shen747/LocalAiRobot/brain/faces/alarmed/01.png

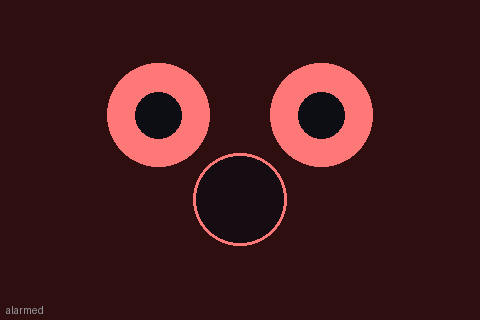
brain/faces/alarmed/01.png
