shen747/LocalAiRobot/brain/faces/exploring/01.png

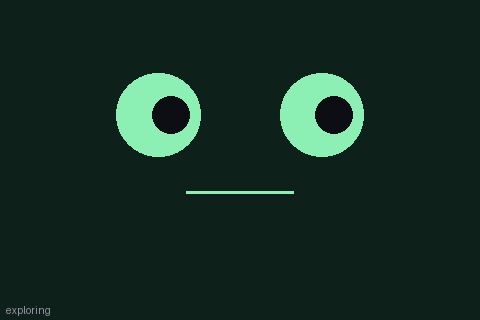
brain/faces/exploring/01.png
