shen747/LocalAiRobot/brain/faces/halloween/04.png

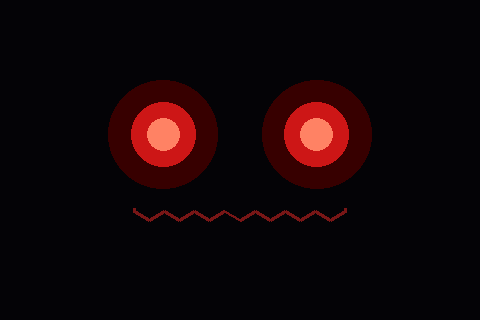
brain/faces/halloween/04.png
