shen747/LocalAiRobot/brain/faces/halloween/05.png

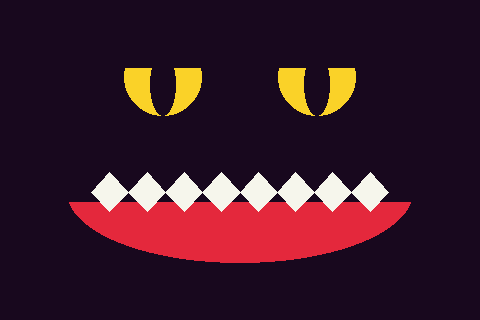
brain/faces/halloween/05.png
