shen747/LocalAiRobot/brain/faces/halloween/06.png

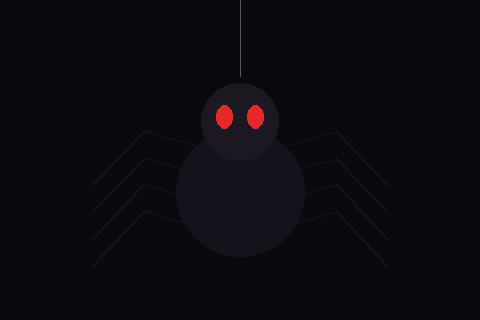
brain/faces/halloween/06.png
