shen747/LocalAiRobot/brain/faces/halloween/08.png

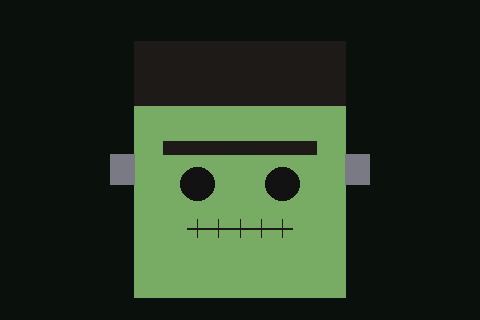
brain/faces/halloween/08.png
