shen747/LocalAiRobot/brain/faces/halloween/09.png

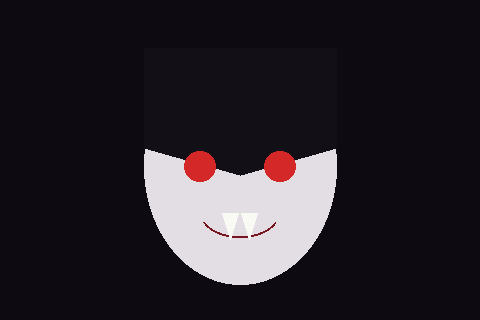
brain/faces/halloween/09.png
