shen747/LocalAiRobot/brain/faces/idle/01.png

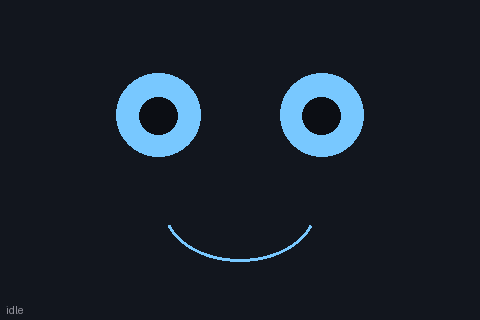
brain/faces/idle/01.png
