shen747/LocalAiRobot/brain/faces/inquisitive/01.png

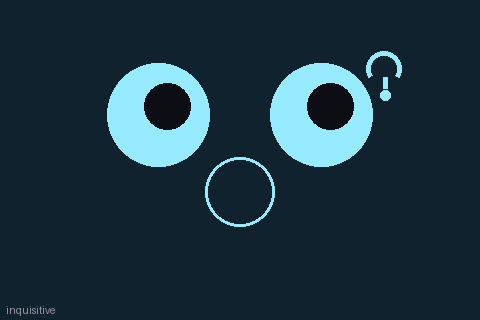
brain/faces/inquisitive/01.png
