shen747/LocalAiRobot/brain/faces/thinking/01.png

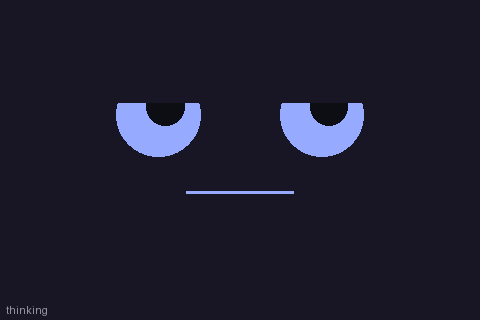
brain/faces/thinking/01.png
