shen747/LocalAiRobot/docs/enclosure_models/junction_box_base.jpg

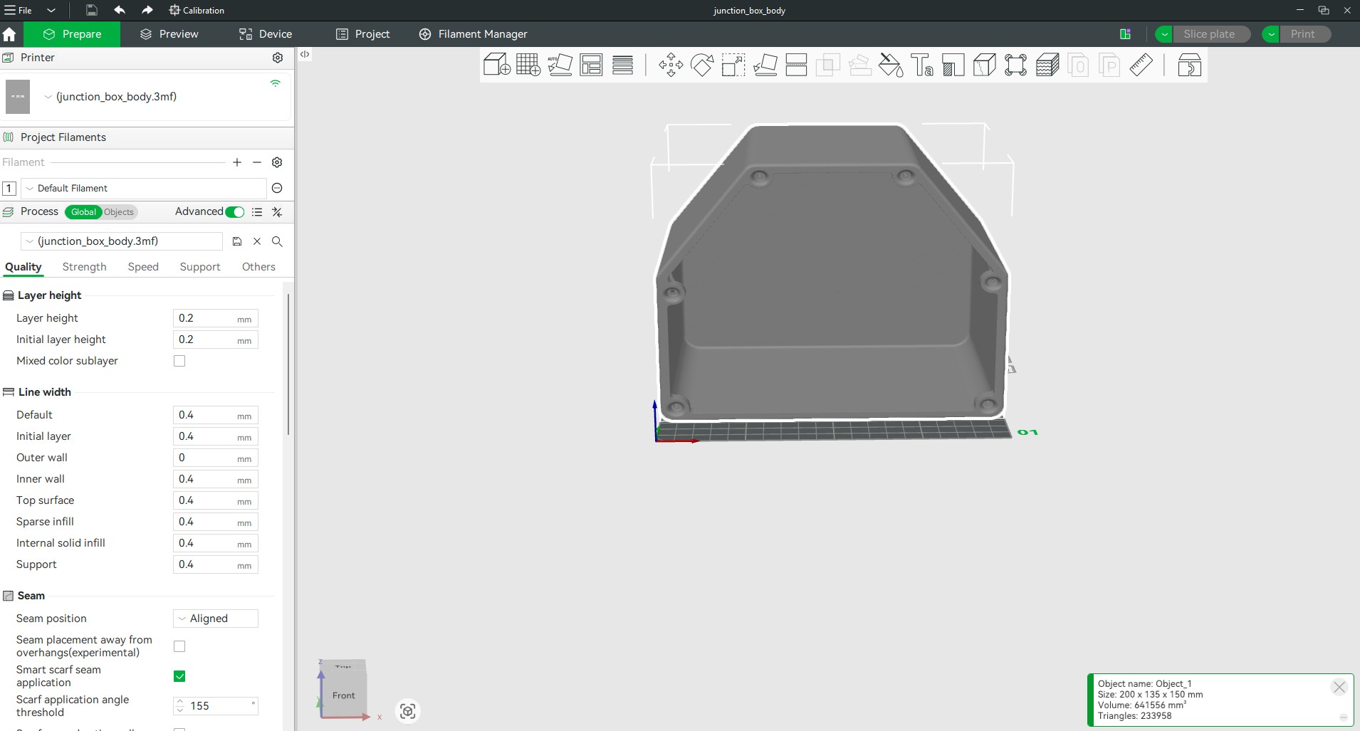
docs/enclosure_models/junction_box_base.jpg
