shen747/LocalAiRobot/docs/enclosure_models/junction_box_base_material.jpg

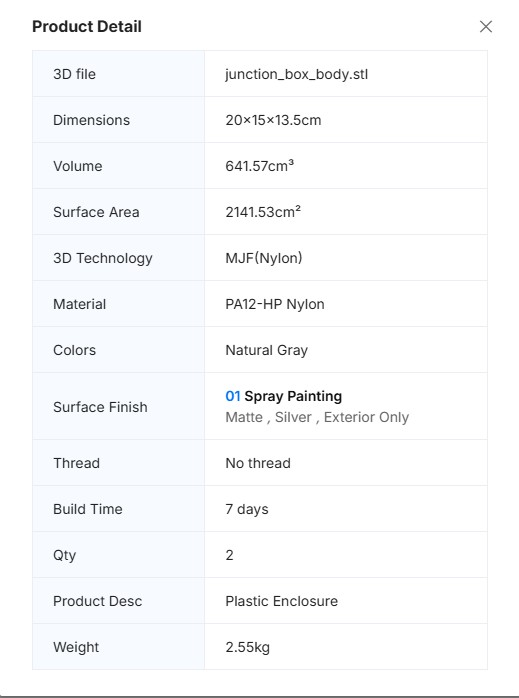
docs/enclosure_models/junction_box_base_material.jpg
