shen747/LocalAiRobot/docs/enclosure_models/junction_box_lid_material.jpg

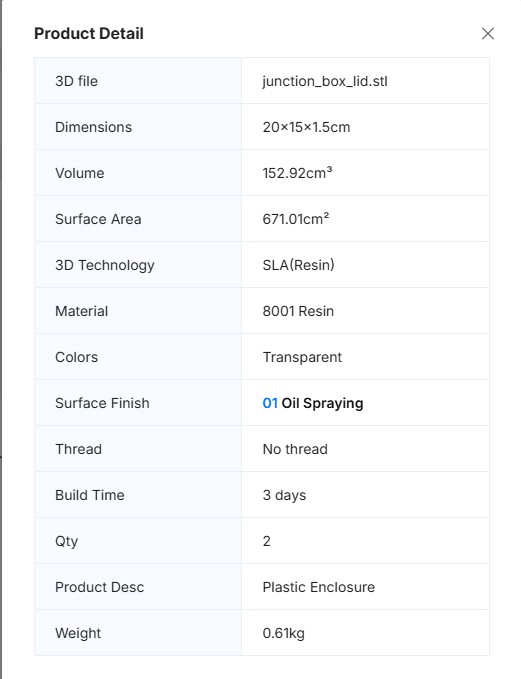
docs/enclosure_models/junction_box_lid_material.jpg
