shen747/LocalAiRobot/docs/enclosure_models/junction_box_lid.3mf

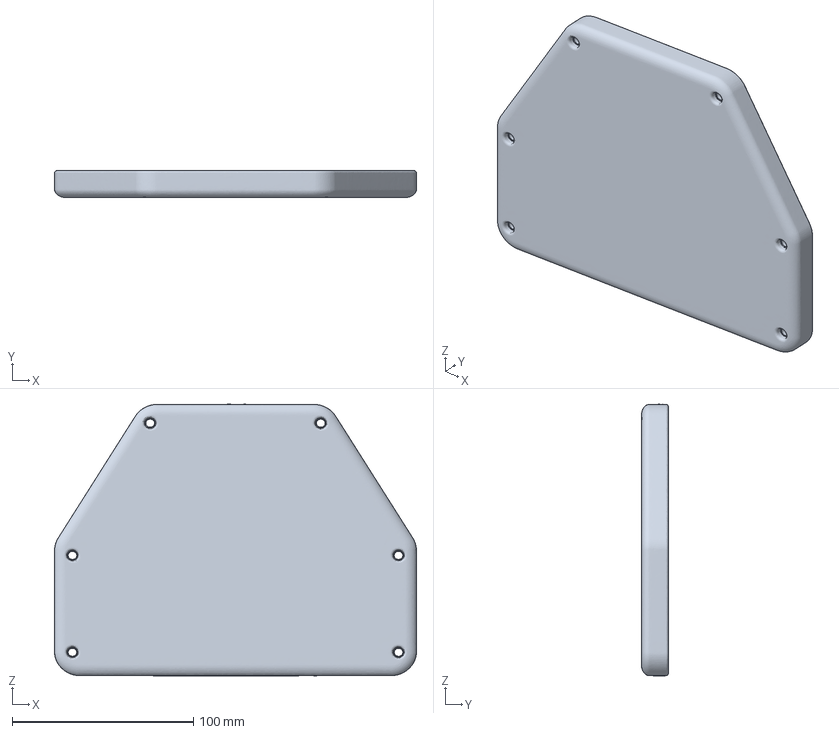
[picture p18: CAD file, 2026-11-03]
docs/enclosure_models/junction_box_lid.3mf
200.0 x 15.0 x 150.0 mm
