shen747/LocalAiRobot/docs/enclosure_models/junction_box_body.3mf

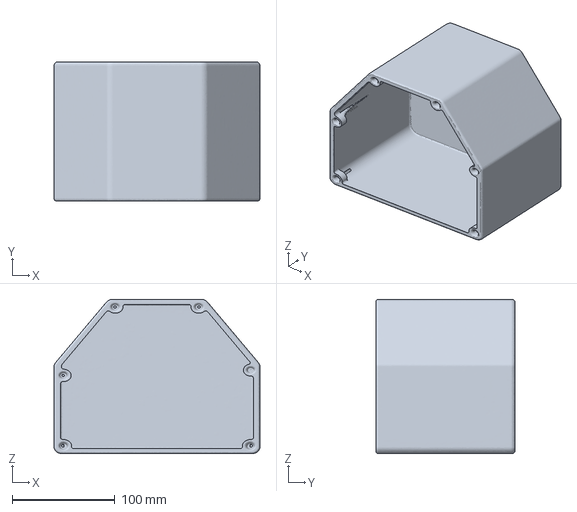
[picture p19: CAD file, 2026-11-03]
docs/enclosure_models/junction_box_body.3mf
200.0 x 135.0 x 150.0 mm
