shen747/LocalAiRobot/docs/images/wiring.png

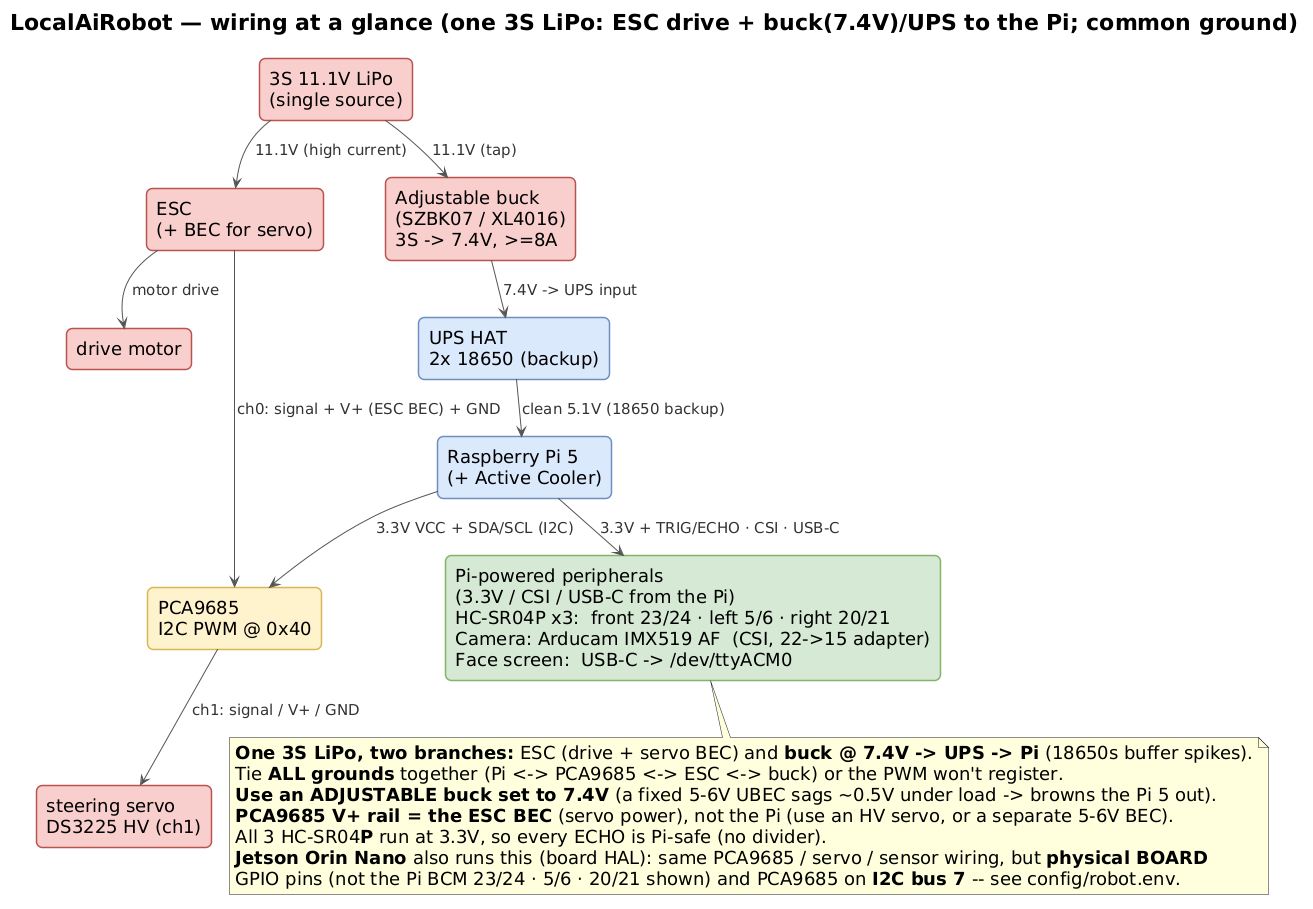
docs/images/wiring.png
