shen747/LocalAiRobot/brain/face.py

# brain/face.py -- the robot's face: an expression state machine on a small display.
#
# main.py / behavior.py call set_expression("listening"|"thinking"|"talking"|"exploring"|
# "happy"|"confused"|"alarmed"|"warmup"|"capturing"|"idle") on events. Each state renders either
# a multi-frame PNG ANIMATION (if assets exist for it) or, as a zero-asset fallback, a procedural
# cartoon face drawn with Pillow. Frames are pushed to a backend:
#
#   turing       -> the 3.5" USB-C panel via mathoudebine/turing-smart-screen-python (serial).
#   framebuffer  -> a DSI/HDMI panel, PIL frame written straight to /dev/fb0 as RGB565
#                   (NOT pygame/SDL -- KMSDRM is broken on headless Pi 5).
#   simulated    -> no display: logs "FACE -> <state>" on change (and optionally dumps a PNG).
#   auto         -> try turing, then framebuffer, else simulated.
#
# ANIMATION: drop PNG sequences in <ROBOT_FACE_FRAMES_DIR>/<state>/NN.png (default brain/faces).
# A state with >=2 frames animates on a background daemon thread (talking is fast + random-frame
# to fake a moving mouth, like the reference); 1 frame = a static still; 0 frames = the procedural
# drawing. Even with NO PNGs, the procedural TALKING face animates its mouth open/closed so speech
# looks alive (see _PROC_ANIMATED); every other state stays a static procedural drawing.
#
# EVERYTHING here is best-effort and never raises into the caller: a missing panel, missing Pillow,
# or an unreadable asset degrades to simulated / procedural and the robot runs on. The face is
# cosmetic; it must never block driving.

import logging
import os
import random
import re
import threading

from driver import dry_run_enabled

log = logging.getLogger("robot.face")

STATES = ("idle", "listening", "thinking", "talking", "exploring",
          "happy", "confused", "alarmed", "warmup", "capturing",
          "inquisitive", "sleeping")

# Per-mood drawing params: bg tint, eye colour, pupil look (dx,dy in -1..1), mouth style,
# and flags for happy (^^) eyes / wide (startled) eyes / drooped lids.
_MOODS = {
    "idle":      dict(bg=(18, 22, 30),  eye=(120, 200, 255), look=(0.0, 0.05),  mouth="smile_s"),
    "listening": dict(bg=(14, 30, 42),  eye=(120, 220, 255), look=(0.0, 0.0),   mouth="o", wide=True),
    "thinking":  dict(bg=(24, 22, 36),  eye=(150, 170, 255), look=(0.35, -0.4), mouth="flat", lid=0.35),
    "talking":   dict(bg=(14, 28, 40),  eye=(120, 210, 255), look=(0.0, 0.0),   mouth="open"),
    "exploring": dict(bg=(14, 32, 26),  eye=(140, 240, 180), look=(0.6, 0.0),   mouth="flat"),
    "happy":     dict(bg=(20, 34, 22),  eye=(150, 255, 160), look=(0.0, 0.0),   mouth="smile_b", happy=True),
    "confused":  dict(bg=(36, 28, 14),  eye=(255, 210, 120), look=(-0.25, -0.1),mouth="wavy", lid=0.3),
    "alarmed":   dict(bg=(46, 14, 14),  eye=(255, 120, 120), look=(0.0, 0.0),   mouth="open", wide=True),
    # added states: warmup (model loading at boot) + capturing (camera grab before a vision look)
    "warmup":    dict(bg=(20, 20, 34),  eye=(160, 180, 255), look=(0.0, 0.0),   mouth="flat", lid=0.2),
    "capturing": dict(bg=(12, 30, 38),  eye=(150, 230, 255), look=(0.0, -0.1),  mouth="o", wide=True),
    # inquisitive: shown the instant "hey jarvis" wakes it -- wide bright eyes glancing up-and-aside, curious
    # "o" mouth (distinct from listening's straight-ahead look). sleeping: shown when a conversation ends on
    # silence -- peaceful CLOSED eyes (sleep=True), a soft smile, and floating "Zzz".
    "inquisitive": dict(bg=(16, 34, 46), eye=(150, 235, 255), look=(0.35, -0.35), mouth="o", wide=True, query=True),
    "sleeping":    dict(bg=(14, 14, 26), eye=(120, 160, 220), look=(0.0, 0.0),    mouth="smile_s", sleep=True),
    # halloween: the spook face shown on a Halloween-mode motion wake. 10 committed PNG frames in
    # brain/faces/halloween/ are shown ONE-AT-RANDOM per visitor (see _RANDOM_STILL); this procedural entry is
    # only the FALLBACK if those PNGs are missing -- a jack-o'-lantern glow (dark bg, orange eyes, jagged mouth).
    "halloween":   dict(bg=(16, 6, 2),   eye=(255, 140, 20),  look=(0.0, 0.0),    mouth="wavy", wide=True),
    # weather: the 3-day forecast CARD that stands in for the sleeping face when weather is enabled and a
    # forecast is in hand (brain/weather_screen.py builds the frames; Face.set_frames registers them). Like
    # halloween this is registered in _MOODS but NOT in STATES -- STATES drives scripts/generate_faces.sh,
    # and a procedurally-drawn cartoon "weather face" is not a thing anyone wants on disk. This entry is
    # purely the whitelist ticket set_expression() demands (an unlisted state is silently coerced to idle)
    # plus a fallback drawing; it is deliberately the sleeping face's palette, because the only way to see
    # it is a card that failed to build, and "asleep" is then the honest thing to show.
    "weather":     dict(bg=(14, 14, 26), eye=(120, 160, 220), look=(0.0, 0.0),    mouth="smile_s", sleep=True),
}

# Per-state animation timing, used ONLY when a state has >=2 PNG frames: (fps, loop).
# talking is the one state where higher fps earns its keep (it tracks speech); the others are a
# cheap slow loop. loop=False holds the last frame (good for brief transient states).
_TIMING = {
    "talking":   (15.0, True),
    "thinking":  (3.0, True),
    "listening": (3.0, True),
    "exploring": (3.0, True),
    "warmup":    (2.0, True),
    "capturing": (2.0, False),
    "happy":     (4.0, False),
    "confused":  (3.0, False),
    "alarmed":   (4.0, True),
    # weather: loop=True is the load-bearing half. An UNLISTED state defaults to loop=False below, which
    # holds the last frame -- the forecast card would animate once and then freeze for the rest of the
    # drowse. The fps here is cosmetic: _timing() substitutes the global ROBOT_FACE_FPS for every state
    # except talking, and the Turing panel clamps that to 10.
    "weather":   (4.0, True),
}
_DEFAULT_TIMING = (2.0, False)

# States that ANIMATE PROCEDURALLY even with no PNG frames -- re-rendered with an advancing frame counter
# so the drawing itself moves (currently just the talking mouth). A >=2-frame PNG set overrides this.
_PROC_ANIMATED = frozenset({"talking"})
# States that show ONE RANDOM frame per entry and HOLD it (vs animating through the whole set). Halloween's
# spook face: a different monster for each trick-or-treater, frozen for that encounter.
_RANDOM_STILL = frozenset({"halloween"})
# talking mouth openness cycle (0 = nearly closed, 1 = wide) -> a mouth-like flap when re-rendered per frame.
_TALK_OPEN = (0.15, 0.55, 1.0, 0.6, 0.25, 0.85, 0.45)
# P2-11: the tiny bench state label is OFF by default (it shipped to the user-facing concierge face). Read
# once at module scope -- the talking face re-renders at up to 10-15 fps. Set ROBOT_FACE_DEBUG_LABEL=1 to show.
_DEBUG_LABEL = os.environ.get("ROBOT_FACE_DEBUG_LABEL", "0").strip().lower() in ("1", "true", "yes", "on")


def _frame_key(name):
    """Sort frames by the integer in the filename: tolerates 'thinking 04.png' and '04.png'."""
    m = re.search(r"(\d+)", name)
    return (int(m.group(1)) if m else 0, name)


def _render(state, w, h, frame=0):
    """Procedural cartoon face -> PIL.Image, or None if Pillow is unavailable. `frame` advances the
    animated bits (the talking mouth); it's ignored for the static moods."""
    try:
        from PIL import Image, ImageDraw
    except Exception:
        return None
    m = _MOODS.get(state, _MOODS["idle"])
    img = Image.new("RGB", (w, h), m["bg"])
    d = ImageDraw.Draw(img)
    eye = m["eye"]
    wide = m.get("wide", False)
    er = h * (0.16 if wide else 0.13)        # eye radius
    cy = h * 0.36                            # eye centre y
    lx, rx = w * 0.33, w * 0.67              # eye centre x (left/right)
    dx, dy = m["look"]

    def draw_eye(cx):
        if m.get("sleep"):                   # closed, peaceful eye = a gentle downward-cup arc (a content ‿)
            d.arc([cx - er, cy - er * 0.6, cx + er, cy + er * 0.7], start=20, end=160,
                  fill=eye, width=max(3, int(er * 0.32)))
            return
        if m.get("happy"):                   # ^^ happy eyes = upward arcs
            d.arc([cx - er, cy - er, cx + er, cy + er], start=200, end=340, fill=eye, width=max(3, int(er * 0.35)))
            return
        d.ellipse([cx - er, cy - er, cx + er, cy + er], fill=eye)          # eyeball
        pr = er * 0.45                                                      # pupil
        px, py = cx + dx * er * 0.5, cy + dy * er * 0.5
        d.ellipse([px - pr, py - pr, px + pr, py + pr], fill=(12, 14, 20))
        lid = m.get("lid", 0.0)                                            # drooped/raised lid
        if lid:
            d.rectangle([cx - er, cy - er, cx + er, cy - er + 2 * er * lid], fill=m["bg"])

    draw_eye(lx)
    draw_eye(rx)

    # mouth. Size it off the SHORT axis (min(w,h)) so a wide landscape canvas doesn't blow the smile up
    # until it runs off the bottom, and sit it a little higher (0.60h) so the big 'happy' smile clears the edge.
    mx, my = w * 0.5, h * 0.60
    mw = min(w, h) * 0.24
    style = m["mouth"]
    line = max(3, int(h * 0.012))
    if style == "smile_s":
        d.arc([mx - mw, my - mw * 0.5, mx + mw, my + mw * 0.9], 20, 160, fill=eye, width=line)
    elif style == "smile_b":
        d.arc([mx - mw, my - mw * 0.7, mx + mw, my + mw * 1.1], 10, 170, fill=eye, width=line + 2)
    elif style == "flat":
        d.line([mx - mw * 0.7, my, mx + mw * 0.7, my], fill=eye, width=line)
    elif style == "o":
        r = mw * 0.45
        d.ellipse([mx - r, my - r, mx + r, my + r], outline=eye, width=line)
    elif style == "open":
        # talking VARIES the openness by frame (fakes a moving mouth); other 'open' moods stay wide.
        amt = _TALK_OPEN[frame % len(_TALK_OPEN)] if state == "talking" else 1.0
        d.ellipse([mx - mw * 0.6, my - mw * 0.5 * amt, mx + mw * 0.6, my + mw * 0.7 * amt],
                  fill=(20, 12, 16), outline=eye, width=line)
    elif style == "wavy":
        pts, n = [], 6
        for i in range(n + 1):
            xx = mx - mw + (2 * mw) * i / n
            yy = my + (mw * 0.18 if i % 2 else -mw * 0.18)
            pts.append((xx, yy))
        d.line(pts, fill=eye, width=line)

    # Sleepy "Zzz" (three ascending Z's, drawn as strokes so no font is needed) + a curious "?" accent.
    if m.get("sleep"):
        for i, s in enumerate((h * 0.05, h * 0.07, h * 0.10)):
            zx, zy = w * (0.66 + i * 0.07), h * (0.30 - i * 0.09)
            _draw_z(d, zx, zy, s, eye, max(2, int(h * 0.012)))
    if m.get("query"):
        _draw_query(d, w * 0.80, h * 0.16, h * 0.11, eye, max(3, int(h * 0.016)))

    if _DEBUG_LABEL:
        d.text((6, h - 16), state, fill=(150, 150, 160))   # bench debug label (ROBOT_FACE_DEBUG_LABEL=1)
    return img


def _draw_z(d, x, y, s, color, wdt):
    """A 'Z' glyph from three strokes (top bar, diagonal, bottom bar) -- no font dependency."""
    d.line([(x, y), (x + s, y)], fill=color, width=wdt)
    d.line([(x + s, y), (x, y + s)], fill=color, width=wdt)
    d.line([(x, y + s), (x + s, y + s)], fill=color, width=wdt)


def _draw_query(d, x, y, s, color, wdt):
    """A '?' glyph: a hooked arc + a dot below -- drawn as strokes so no font is needed."""
    r = s * 0.5
    d.arc([x - r, y, x + r, y + s], start=150, end=390, fill=color, width=wdt)  # the top hook
    d.line([(x + r * 0.1, y + s * 0.75), (x + r * 0.1, y + s * 1.05)], fill=color, width=wdt)  # stem
    dot = max(wdt, int(s * 0.10))
    d.ellipse([x + r * 0.1 - dot, y + s * 1.25 - dot, x + r * 0.1 + dot, y + s * 1.25 + dot], fill=color)  # dot


class _SimulatedBackend:
    def __init__(self, w, h):
        self.width, self.height = w, h
        self._dump = os.environ.get("ROBOT_FACE_DUMP", "").strip()  # optional dir to save PNGs
        self._last = None
        log.info("face backend: simulated (no panel; logs expressions on change%s)",
                 f", dumps PNGs to {self._dump}" if self._dump else "")

    def show(self, state, img):
        # Log + dump only on a STATE CHANGE so animation frames don't flood the console / disk.
        if state == self._last:
            return
        self._last = state
        log.info("FACE -> %s", state)
        if self._dump and img is not None:
            try:
                os.makedirs(self._dump, exist_ok=True)
                img.save(os.path.join(self._dump, f"face_{state}.png"))
            except Exception:
                pass

    def close(self):
        pass


class _TuringBackend:
    """USB-C panel via mathoudebine/turing-smart-screen-python (serial protocol).

    Orientation: the panel is portrait-native (e.g. 320x480). ROBOT_FACE_ORIENTATION rotates the rendered
    face into the panel's frame so a panel MOUNTED SIDEWAYS reads upright. 'landscape'/'reverse_landscape'
    draw the face on a WIDE logical canvas (e.g. 480x320) -- so the whole face system (procedural renderer
    + PNG assets) lays out horizontally -- and show() rotates it 90deg into the native portrait frame right
    before the serial push. 'portrait' is the native frame; 'reverse_landscape'/'reverse_portrait' flip
    which edge is 'up' (use them if the face comes out upside-down for your mounting).

    Speed: a full frame is a slow serial paint on rev A (you watch it 'slide' in). When only PART of the
    face changed between frames (e.g. the talking mouth), we send just that bounding box via a positioned
    DisplayPILImage -- far less serial traffic -- and skip the push entirely when nothing changed. A big
    change (a mood switch repaints most of the screen) still sends a full frame. ROBOT_FACE_PARTIAL=0
    forces full frames (set it if a panel mis-renders positioned sub-images)."""

    def __init__(self, w, h, port, revision, brightness, libdir, orientation="landscape", partial=True):
        import sys
        sys.path.insert(0, os.path.expanduser(libdir))
        rev = (revision or "A").upper()
        if rev == "B":
            from library.lcd.lcd_comm_rev_b import LcdCommRevB as Lcd
        else:
            from library.lcd.lcd_comm_rev_a import LcdCommRevA as Lcd
        # Panel NATIVE geometry is portrait (width <= height); the library always talks to it in that frame.
        self._nw, self._nh = min(w, h), max(w, h)
        self._orient = (orientation or "landscape").lower()
        # LOGICAL canvas the face is DRAWN on (what a viewer sees). Landscape swaps the axes so the renderer
        # and PNG assets lay out wide; show() rotates back to native before the push.
        if self._orient in ("landscape", "reverse_landscape"):
            self.width, self.height = self._nh, self._nw
        else:
            self.width, self.height = self._nw, self._nh
        self._partial = partial
        self._np = None
        if partial:
            try:
                import numpy as np                    # only needed for the changed-region diff
                self._np = np
            except Exception:
                self._partial = False                 # no numpy -> full frames only
        self._last = None                             # last image pushed, in NATIVE orientation (diff basis)
        # The turing library's openSerial() does `try: sys.exit(0) except: os._exit(0)` when it can't
        # auto-find the panel's COM port. os._exit() is UNCATCHABLE -- it hard-kills the whole brain
        # (our _try's `except SystemExit` never sees it). So when the port is AUTO, detect the panel
        # OURSELVES first and raise a NORMAL exception (which _try catches -> falls back to
        # framebuffer/simulated) instead of letting the library reach that os._exit().
        com = (port or "AUTO").strip()
        if com.upper() == "AUTO":
            detect = getattr(Lcd, "auto_detect_com_port", None)
            found = detect() if callable(detect) else None
            if not found:
                raise RuntimeError("no turing panel detected on any serial port "
                                   "(plug it in + set ROBOT_FACE_PORT, or ROBOT_FACE_BACKEND=simulated)")
            com = found
        self._lcd = Lcd(com_port=com, display_width=self._nw, display_height=self._nh)
        self._lcd.Reset()
        self._lcd.InitializeComm()
        try:
            self._lcd.SetBrightness(level=brightness)
        except Exception:
            pass
        log.info("face backend: turing USB-C panel rev%s (native %dx%d, %s %dx%d, port=%s, partial=%s)",
                 rev, self._nw, self._nh, self._orient, self.width, self.height, port or "AUTO", self._partial)

    def _to_native(self, img):
        """Rotate the logical (viewer-space) face into the panel's native portrait frame. PIL rotate() is
        counter-clockwise; a 90/180/270 rotation of a rectangle needs no padding (expand keeps every pixel)."""
        if self._orient == "landscape":
            return img.rotate(-90, expand=True)       # 90 CW:  480x320 -> 320x480
        if self._orient == "reverse_landscape":
            return img.rotate(90, expand=True)        # 90 CCW: the other way up
        if self._orient == "reverse_portrait":
            return img.rotate(180, expand=True)
        return img                                    # portrait: already native

    def _changed_box(self, a_img, b_img):
        """(left, top, right, bottom) of pixels that differ between two same-size images (right/bottom
        exclusive, PIL-crop convention), or None if identical."""
        np = self._np
        a = np.asarray(a_img.convert("RGB"))
        b = np.asarray(b_img.convert("RGB"))
        diff = np.any(a != b, axis=2)
        if not diff.any():
            return None
        rows = np.where(diff.any(axis=1))[0]
        cols = np.where(diff.any(axis=0))[0]
        return int(cols[0]), int(rows[0]), int(cols[-1]) + 1, int(rows[-1]) + 1

    def show(self, state, img):
        if img is None:
            return
        cur = self._to_native(img)
        if cur.size != (self._nw, self._nh):          # safety: match the panel frame exactly
            cur = cur.resize((self._nw, self._nh))
        try:
            if self._partial and self._last is not None and self._last.size == cur.size:
                box = self._changed_box(self._last, cur)
                if box is None:
                    return                            # nothing changed -> skip the serial push entirely
                left, top, right, bottom = box
                frac = ((right - left) * (bottom - top)) / float(self._nw * self._nh)
                if frac < 0.7:                        # small change -> push only that region (fast)
                    self._lcd.DisplayPILImage(cur.crop(box), left, top)
                    self._last = cur
                    return
            self._lcd.DisplayPILImage(cur)            # first frame / big change / no numpy -> full frame
            self._last = cur
        except Exception as e:
            log.warning("face: turing update failed (%s) -- retrying full frame", e)
            try:
                self._lcd.DisplayPILImage(cur)
                self._last = cur
            except Exception:
                pass

    def close(self):
        try:
            self._lcd.closeSerial()
        except Exception:
            pass


class _FramebufferBackend:
    """A DSI/HDMI panel (e.g. a Freenove 5" 800x480 DSI touchscreen, or any HDMI screen): write the
    PIL frame straight to /dev/fb0 (no X, no pygame -- KMSDRM is broken on a headless Pi 5).

    Handles BOTH common framebuffer depths, picked from sysfs: 16-bit RGB565 (a legacy/console fb)
    and 32-bit XRGB8888 (what the Pi 5 KMS driver gives a DSI/HDMI panel). Hardcoding 16bpp -- the old
    behaviour -- silently memmaps only half a 32bpp buffer and renders garbage, so the depth check is
    what makes a modern DSI screen actually work. Geometry is read from the fb too, so an 800x480 panel
    is auto-sized (ROBOT_FACE_WIDTH/HEIGHT are ignored here). The capacitive touch layer is unused --
    the face is display-only. Assumes the fb row stride has no extra padding (true for 800x480)."""

    def __init__(self, w, h, dev="/dev/fb0"):
        import numpy as np
        self.dev = dev
        self._np = np
        try:
            with open("/sys/class/graphics/fb0/virtual_size") as f:
                vw, vh = (int(x) for x in f.read().strip().split(","))
            self.width, self.height = vw, vh
        except Exception:
            self.width, self.height = w, h
        try:
            with open("/sys/class/graphics/fb0/bits_per_pixel") as f:
                self.bpp = int(f.read().strip())
        except Exception:
            self.bpp = 16
        if self.bpp not in (16, 32):
            raise RuntimeError(f"unsupported framebuffer depth {self.bpp}bpp (need 16 or 32)")
        # Probe writability early so auto() can fall back if it fails.
        open(self.dev, "r+b").close()
        # Map the framebuffer ONCE and reuse it -- under animation, re-opening a memmap every
        # frame (the old behaviour) is needless churn. Per-frame show() is now just pack + write.
        dtype = "uint16" if self.bpp == 16 else "uint32"
        self._fb = np.memmap(self.dev, dtype=dtype, mode="r+", shape=(self.height, self.width))
        log.info("face backend: framebuffer %s (%dx%d %dbpp, persistent map)",
                 self.dev, self.width, self.height, self.bpp)

    def show(self, state, img):
        if img is None or self._fb is None:
            return
        np = self._np
        a = np.asarray(img.resize((self.width, self.height)).convert("RGB"), dtype=np.uint32)
        r, g, b = a[:, :, 0], a[:, :, 1], a[:, :, 2]
        if self.bpp == 16:
            self._fb[:] = (((r >> 3) << 11) | ((g >> 2) << 5) | (b >> 3)).astype(np.uint16)
        else:
            # XRGB8888 (0xFFRRGGBB). If red/blue ever look swapped on your panel, swap r and b here.
            self._fb[:] = (np.uint32(0xFF000000) | (r << 16) | (g << 8) | b)

    def close(self):
        self._fb = None


class Face:
    """Expression state machine with optional PNG-sequence animation. set_expression() is
    best-effort and never raises; the animator runs on a daemon thread."""

    def __init__(self):
        self.enabled = os.environ.get("ROBOT_FACE_ENABLE", "1") == "1"
        self.dry_run = dry_run_enabled()
        self.backend = None
        self._state = None
        # animation state (guarded by _anim_lock; _wake interrupts the frame-wait on a change)
        self._anim_lock = threading.Lock()
        self._wake = threading.Event()
        self._stop = threading.Event()
        self._thread = None
        self._frame_index = 0
        self._frame_cache = {}
        self._max_fps = 30.0
        self._frames_dir = os.path.expanduser(
            os.environ.get("ROBOT_FACE_FRAMES_DIR", "").strip()
            or os.path.join(os.path.dirname(os.path.abspath(__file__)), "faces"))
        try:
            self._fps = float(os.environ.get("ROBOT_FACE_FPS", "4") or 4)
        except ValueError:
            self._fps = 4.0

        if not self.enabled:
            log.info("face disabled (ROBOT_FACE_ENABLE=0)")
            return

        w = int(os.environ.get("ROBOT_FACE_WIDTH", "320") or 320)
        h = int(os.environ.get("ROBOT_FACE_HEIGHT", "480") or 480)
        want = os.environ.get("ROBOT_FACE_BACKEND", "auto").lower()
        port = os.environ.get("ROBOT_FACE_PORT", "AUTO")
        rev = os.environ.get("ROBOT_FACE_REVISION", "A")
        libdir = os.environ.get("ROBOT_FACE_LIB", "~/turing-smart-screen-python")
        orient = os.environ.get("ROBOT_FACE_ORIENTATION", "landscape").strip().lower()
        partial = (os.environ.get("ROBOT_FACE_PARTIAL", "1").strip() != "0")
        try:
            bright = int(os.environ.get("ROBOT_FACE_BRIGHTNESS", "80") or 80)
        except ValueError:
            bright = 80

        def _turing():
            return _TuringBackend(w, h, port, rev, bright, libdir, orient, partial)

        if self.dry_run or want == "simulated":
            self.backend = _SimulatedBackend(w, h)
        elif want == "turing":
            self.backend = self._try(_turing) or _SimulatedBackend(w, h)
        elif want == "framebuffer":
            self.backend = self._try(lambda: _FramebufferBackend(w, h)) or _SimulatedBackend(w, h)
        else:  # auto
            self.backend = (self._try(_turing)
                            or self._try(lambda: _FramebufferBackend(w, h))
                            or _SimulatedBackend(w, h))

        # Serial-bound turing panel can't sustain high fps; clamp it (partial updates make the talking mouth
        # cheap, so it can run a little higher than a full-frame panel). ROBOT_FACE_MAX_FPS overrides.
        default_cap = 10.0 if isinstance(self.backend, _TuringBackend) else 30.0
        try:
            cap = float(os.environ.get("ROBOT_FACE_MAX_FPS", "") or 0)
        except ValueError:
            cap = 0.0
        self._max_fps = cap if cap > 0 else default_cap

        self._thread = threading.Thread(target=self._animate, daemon=True)
        self._thread.start()
        self.set_expression("idle")

    @staticmethod
    def _try(make):
        # Backstop: catch SystemExit as well as Exception so a backend that exits can't take the brain
        # with it. NOTE the turing library escalates an unfound COM port to os._exit() (UNCATCHABLE) --
        # that specific case is pre-empted by detecting the panel in _TuringBackend before the library's
        # openSerial() runs, so we never reach its exit path. This clause covers the catchable variants.
        try:
            return make()
        except SystemExit as e:
            log.warning("face backend init failed (library called sys.exit(%s)) -- trying next", e.code)
            return None
        except Exception as e:
            log.warning("face backend init failed (%s) -- trying next", e)
            return None

    def set_expression(self, state):
        if not self.enabled or self.backend is None:
            return
        if state not in _MOODS:
            state = "idle"
        with self._anim_lock:
            if state == self._state:
                return            # same state -> no restart, no flicker
            self._state = state
            self._frame_index = 0
        self._wake.set()          # interrupt the animator's wait so it picks up the new state now

    # ---------- animation ----------
    def _animate(self):
        while not self._stop.is_set():
            with self._anim_lock:
                state = self._state
                idx = self._frame_index
            if state is None:
                self._wake.wait(0.2)
                self._wake.clear()
                continue
            frames = self._frames_for(state)
            if state in _RANDOM_STILL and frames:
                # Halloween spook: show ONE random frame (a different monster per entry), hold until the next
                # state change. Re-entered fresh for each visitor (from sleeping/idle) -> re-randomises.
                self._show(state, random.choice(frames))
                self._wake.wait()
                self._wake.clear()
            elif frames and len(frames) >= 2:
                self._show(state, frames[idx % len(frames)])
                fps, loop = self._timing(state)
                with self._anim_lock:
                    if self._state == state:   # don't clobber a state change that just landed
                        self._frame_index = self._next_index(state, idx, len(frames), loop)
                if self._wake.wait(1.0 / max(0.5, fps)):
                    self._wake.clear()
            elif state in _PROC_ANIMATED:
                # No >=2-frame PNG set, but this state animates PROCEDURALLY (e.g. the talking mouth):
                # re-render the procedural face with an advancing frame counter at the state's fps, so it
                # moves with ZERO art files. (A single static PNG here is ignored in favour of the animation.)
                self._show(state, _render(state, self.backend.width, self.backend.height, idx))
                fps, _ = self._timing(state)
                with self._anim_lock:
                    if self._state == state:
                        self._frame_index = idx + 1
                if self._wake.wait(1.0 / max(0.5, fps)):
                    self._wake.clear()
            else:
                # single frame -> static still; no frames -> procedural drawing. Either way, render
                # once and block until the next state change (no busy spin, no log/serial spam).
                self._show(state, frames[0] if frames else _render(state, self.backend.width, self.backend.height))
                self._wake.wait()
                self._wake.clear()
        self._stop.clear()

    def _next_index(self, state, idx, n, loop):
        if state == "talking" and n > 1:
            return random.randint(1, n - 1)   # random mouth frame -> looks like speech
        nxt = idx + 1
        if nxt >= n:
            return 0 if loop else n - 1        # loop, or hold the last frame
        return nxt

    def _timing(self, state):
        tbl_fps, loop = _TIMING.get(state, _DEFAULT_TIMING)
        fps = tbl_fps if state == "talking" else self._fps   # global ROBOT_FACE_FPS; talking faster
        return min(fps, self._max_fps), loop

    def _frames_for(self, state):
        if state not in self._frame_cache:
            self._frame_cache[state] = self._load_frames(state)
        return self._frame_cache[state]

    def _load_frames(self, state):
        d = os.path.join(self._frames_dir, state)
        if not os.path.isdir(d):
            return []
        try:
            from PIL import Image
            files = sorted([f for f in os.listdir(d) if f.lower().endswith(".png")], key=_frame_key)
            frames = []
            for f in files:
                img = Image.open(os.path.join(d, f)).convert("RGB").resize(
                    (self.backend.width, self.backend.height))
                frames.append(img)
            if frames:
                log.info("face: loaded %d frame(s) for '%s' from %s", len(frames), state, d)
            return frames
        except Exception as e:
            log.warning("face: frame load failed for '%s' (%s) -- using procedural", state, e)
            return []

    def set_frames(self, state, frames):
        """Register animation frames for `state` IN MEMORY, replacing whatever _load_frames put there.
        Returns True when they were stored. A no-op (False) on a disabled/backend-less face.

        WHY THIS EXISTS. Every other state's art is static PNGs read from disk ONCE per process and cached
        forever (_frames_for never invalidates). The weather card is neither: it is generated from live data
        every poll, so a disk-based route would need cache invalidation AND would write to the SD card every
        30 minutes for the life of the robot. Registering the frames in memory sidesteps both.

        Frames are converted and resized here, on the CALLER's thread (the weather poller), so the animation
        loop never pays for it. The write is atomic from the animator's point of view -- it re-reads
        self._frame_cache[state] each pass and gets either the whole old list or the whole new one."""
        if not self.enabled or self.backend is None:
            return False
        if state not in _MOODS:
            log.warning("face: set_frames(%r) -- unregistered state, ignored (add it to _MOODS)", state)
            return False
        try:
            w, h = self.backend.width, self.backend.height
            out = []
            for img in (frames or []):
                if img.mode != "RGB":
                    img = img.convert("RGB")
                if img.size != (w, h):
                    img = img.resize((w, h))
                out.append(img)
        except Exception as e:
            log.warning("face: set_frames(%s) failed (%s) -- keeping the previous frames", state, e)
            return False
        if not out:
            return False
        with self._anim_lock:
            self._frame_cache[state] = out
            showing = (self._state == state)
            if showing:
                self._frame_index = 0
        if showing:
            self._wake.set()      # on screen right now -> interrupt the frame wait so the new card shows
        return True

    def _show(self, state, img):
        try:
            self.backend.show(state, img)
        except Exception as e:
            log.warning("face render/show failed (%s)", e)

    def close(self):
        self._stop.set()
        self._wake.set()
        if self._thread is not None and self._thread.is_alive():
            self._thread.join(timeout=1.0)
        if self.backend is not None:
            try:
                self.backend.show("idle", _render("idle", self.backend.width, self.backend.height))
            except Exception:
                pass
            try:
                self.backend.close()
            except Exception:
                pass
